ControlLTH/OmniBot/design_files/STL_files/Omni_Bot_PCBs_holder_long.stl

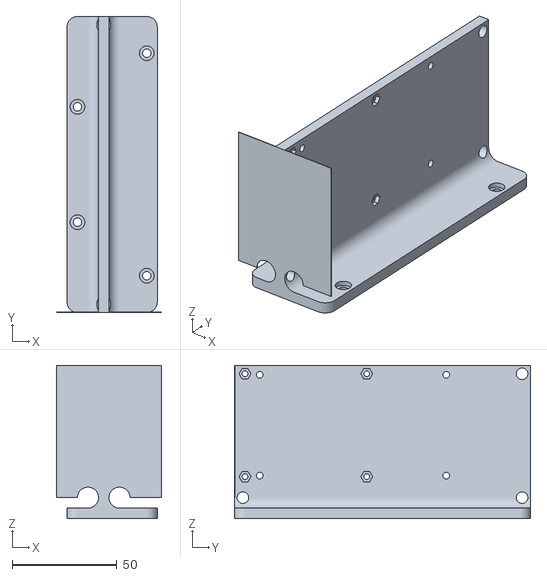
[picture p5: CAD file, 2022-08-08]
design_files/STL_files/Omni_Bot_PCBs_holder_long.stl
50.0 x 141.0 x 73.0
