ControlLTH/OmniBot/design_files/STL_files/Omni_Bot_PCBs_holder.stl

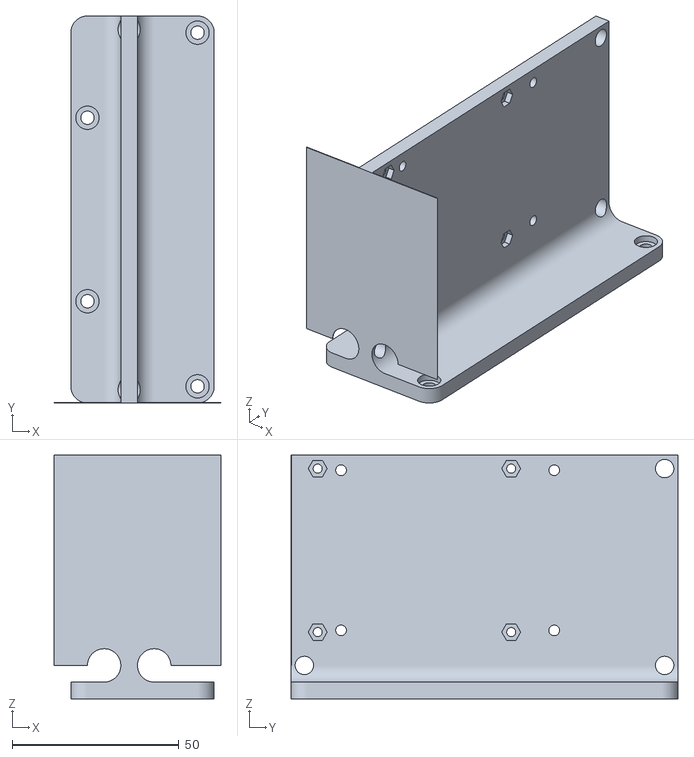
[picture p6: CAD file, 2022-08-08]
design_files/STL_files/Omni_Bot_PCBs_holder.stl
50.0 x 116.0 x 73.0
