ControlLTH/OmniBot/(list of files, cad)

Other CAD files:
design_files/OpenSCAD_files/Omni_Bot_PCBs_holder_long.scad
