ControlLTH/OmniBot/Electrical_part/KiCAD_files/Supply_5V.kicad_pcb

## KiCad design Electrical_part/KiCAD_files/Supply_5V.kicad_pcb (2022-06-03)

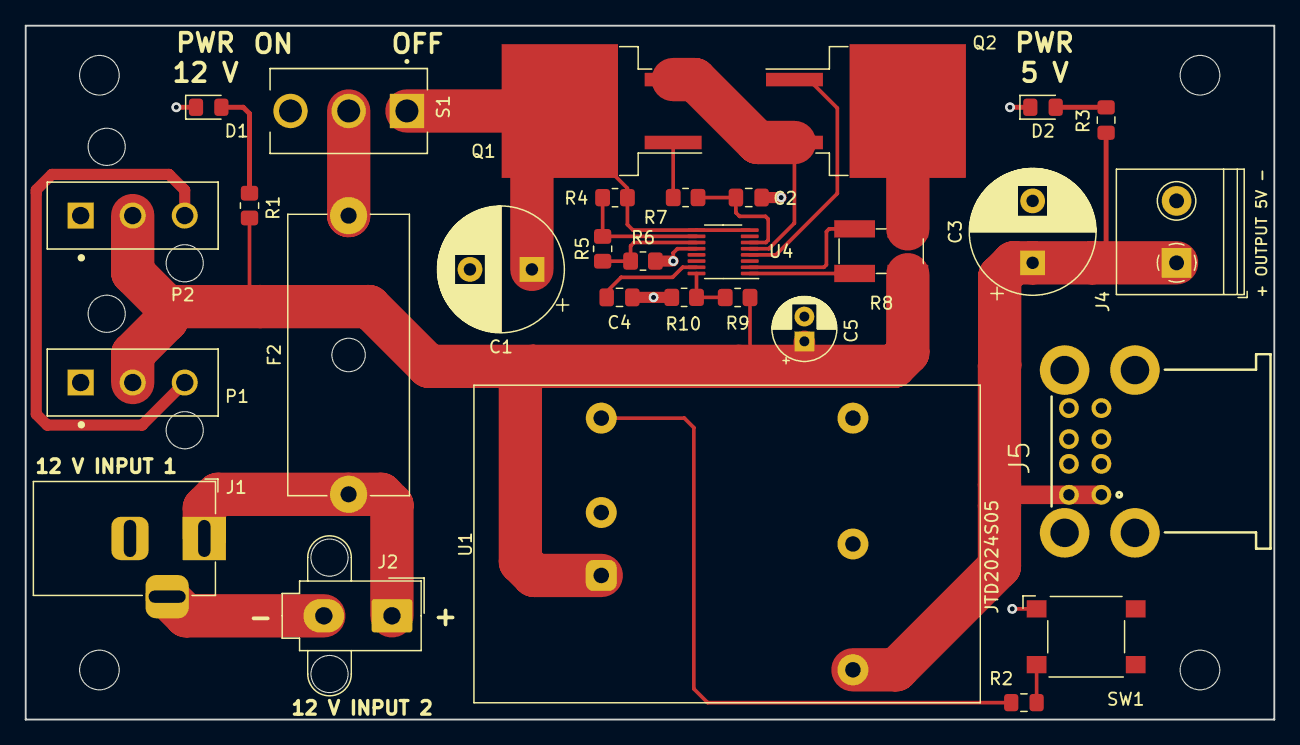
[picture p7: board Supply_5V.kicad_pcb from above]

Board: 2 copper layers, 100.8 x 56.0 mm, 34 parts (0 on the bottom side), 23 nets.

Parts:
C1, C3: EEEFK1A222AQ; CP_Radial_D10.0mm_P5.00mm
C2, C4: C; C_0805_2012Metric_Pad1.18x1.45mm_HandSolder
C5: C_Polarized; CP_Radial_D5.0mm_P2.00mm
D1, D2: LED; LED_0805_2012Metric_Pad1.15x1.40mm_HandSolder
F2: Fuse; Fuseholder_Cylinder-5x20mm_Schurter_0031_8201_Horizontal_Op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
H1, H2, H3, H4: MountingHole; MountingHole_3.2mm_M3
J1: 12 V INPUT; BarrelJack_Horizontal
J2: Conn_01x02_Male; Molex_Mini-Fit_Jr_5566-02A2_2x01_P4.20mm_Vertical
J4: Screw_Terminal_01x02; TerminalBlock_Philmore_TB132_1x02_P5.00mm_Horizontal
J5: USB1035-XX-X-X-X-B_REVE; GCT_USB1035-XX-X-X-X-B_REVE
P1, P2: 39-30-1039; MOLEX_39-30-1039
Q1: FDB33N25; TO-263-2
Q2: FDB3682; TO-263-2
R1, R4, R5, R6, R7, R9, R10: R; R_0805_2012Metric_Pad1.20x1.40mm_HandSolder
R2, R3: R; R_0805_2012Metric_Pad1.15x1.40mm_HandSolder
R8: R_Shunt; R_Shunt_Ohmite_LVK25
S1: OFF ON; SW_100SP1T1B4M2QE
SW1: SW_Push_Dual; SW_SPST_Omron_B3FS-100xP
U1: JTD2024S05; Converter_DCDC_XP_POWER_JTDxxxxxxx_THT
U4: LTC4364IMS; MSOP-16_3x4.039mm_P0.5mm

Connections:
GND: C1.2, C2.1, C3.2, C4.1, C5.2, D1.1 (K), D2.1 (K), J1.2, J4.2, J5.4A (GND1), J5.4B (GND2), P1.1, P2.1, R6.1, R10.1, SW1.1, U1.2 (-VIN), U1.5 (-VOUT), U4.12 (GND)
unnamed: C1.1, Q1.2 (D), R4.2, S1.1, U4.8 (VCC), U4.9 (~SHDN)
unnamed: C2.2, R7.1, U4.6 (HGATE)
unnamed: C3.1, J4.1, J5.1A (VBUS1), J5.1B (VBUS2), R3.2, U1.3 (+VOUT)
unnamed: C4.2, U4.15 (TMR)
unnamed: C5.1, P1.2, P2.2, R1.2, R8.4, R9.2, U1.1 (+VIN)
unnamed: D1.2 (A), R1.1
unnamed: D2.2 (A), R3.1
unnamed: F2.1, J1.1, J2.1
unnamed: F2.2, S1.2
unnamed: J1.3, J2.2
unnamed: P1.3, P2.3
unnamed: Q1.1 (G), R7.2
unnamed: Q1.3 (S), Q2.3 (S), U4.5 (SOURCE)
unnamed: Q2.1 (G), U4.4 (DGATE)
unnamed: Q2.2 (D), R8.1
unnamed: R2.1, U1.6 (On/~Off)
unnamed: R2.2, SW1.3
unnamed: R4.1, R5.2, U4.10 (UV)
unnamed: R5.1, R6.2, U4.11 (OV)
unnamed: R8.2, U4.1 (OUT)
unnamed: R8.3, U4.2 (SENSE)
unnamed: R9.1, R10.2, U4.16 (FB)
